narzul/intelligent-patient-record/README.md

intelligent-patient-record
==========================

intelligent patient record
