narzul/intelligent-patient-record/Report/Appendix.tex

\clearpage

\begin{appendices}

\begin{figure}[h]
\setlength{\belowcaptionskip}{-5mm}
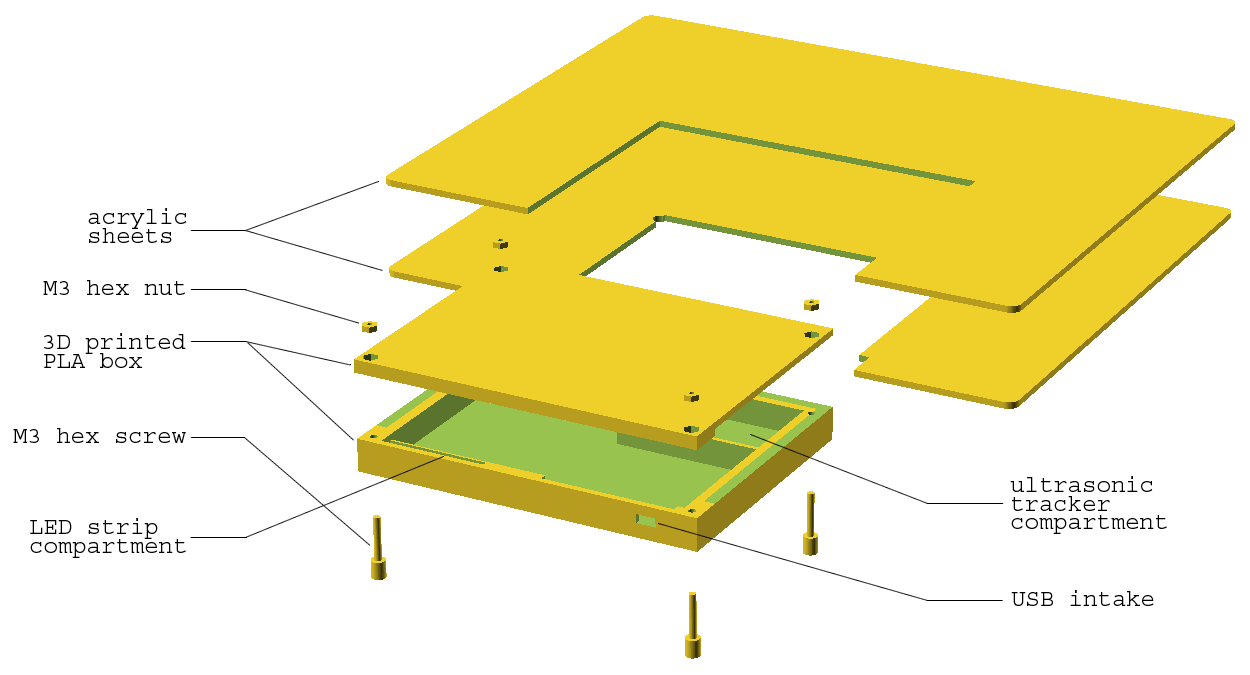
[picture p1: Report/figures/explode.png]
  \makebox[\textwidth][c]{} %
  \caption{\small {\it {Exploded view of the prototype.}}} 
  \label{fig:explode}
\end{figure}

\begin{figure}[h]
\setlength{\belowcaptionskip}{-5mm}
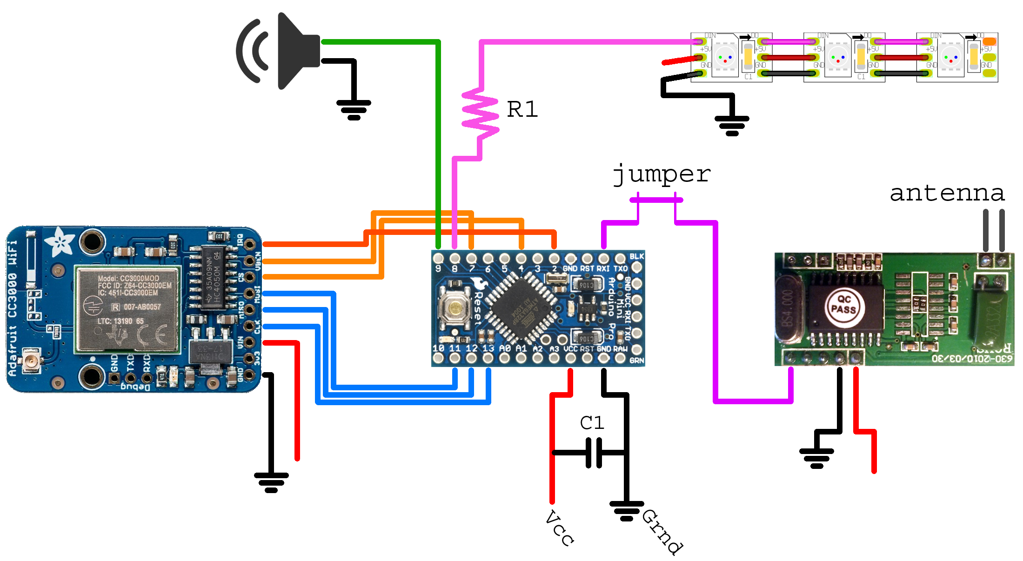
[picture p2: Report/figures/schematic.png]
  \makebox[\textwidth][c]{} %
  \caption{\small {\it {Schematic of the electronics inside.}}} 
  \label{fig:explode}
\end{figure}

\begin{figure}[h]
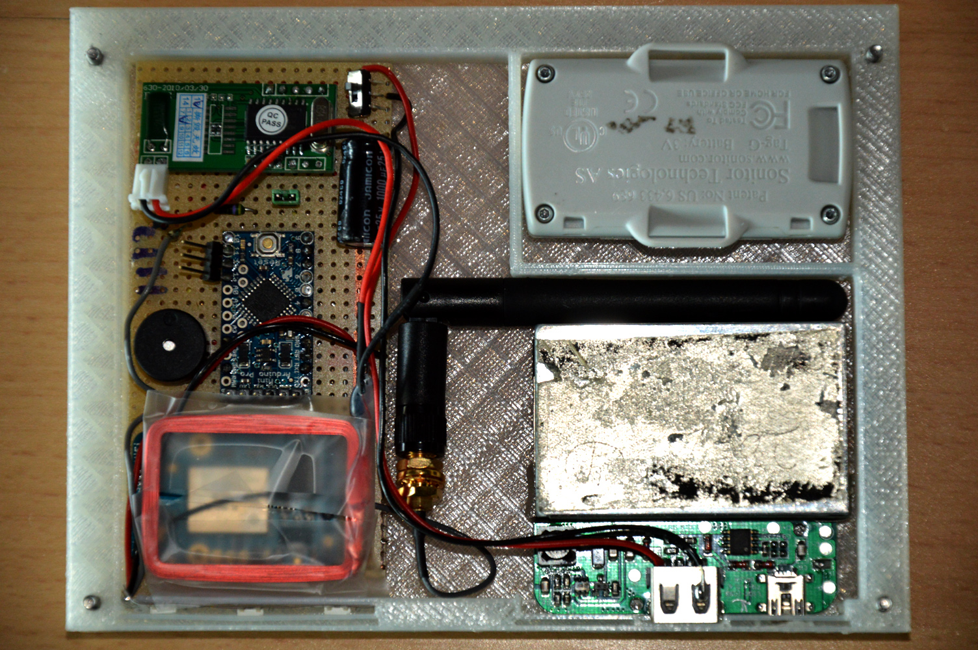
[picture p3: Report/figures/internals.jpg]
  \makebox[\textwidth][c]{}
  \caption{\small {\it {Inside the electronics compartment.}}} 
  \label{fig:internals}
\end{figure}

\begin{figure}[h]
  \begin{minipage}[b]{.5\textwidth}
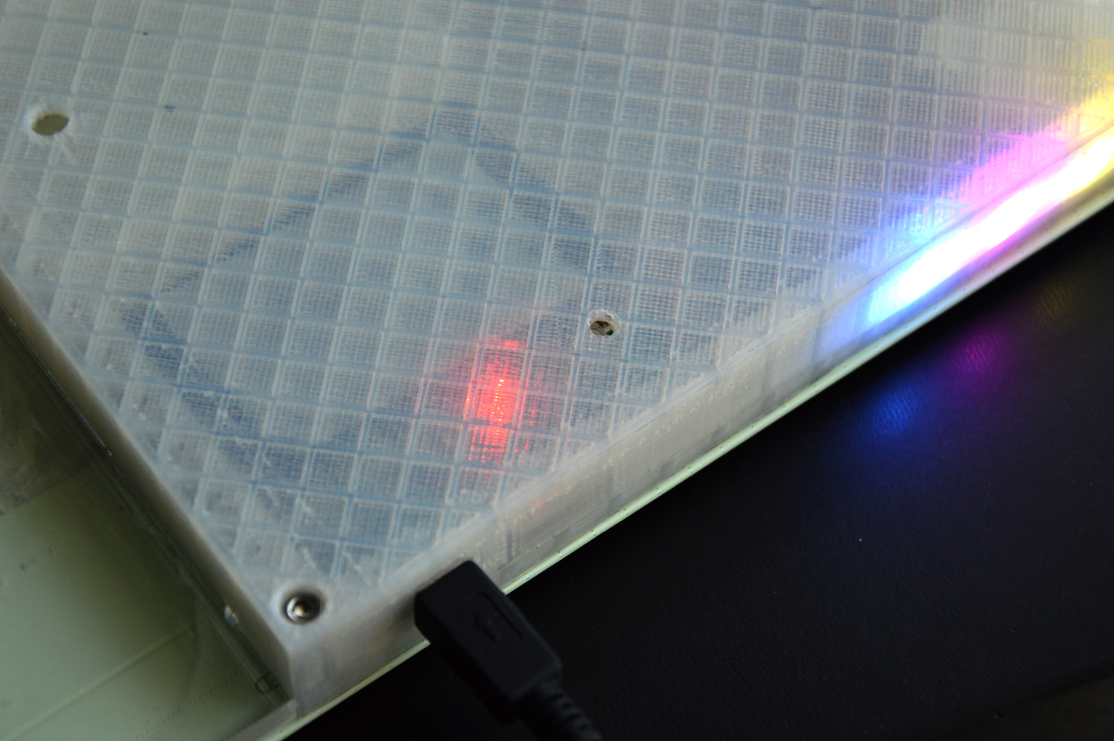
[picture p4: Report/figures/journal-charging.jpg]
    
  \end{minipage}
  \begin{minipage}[b]{.5\textwidth}
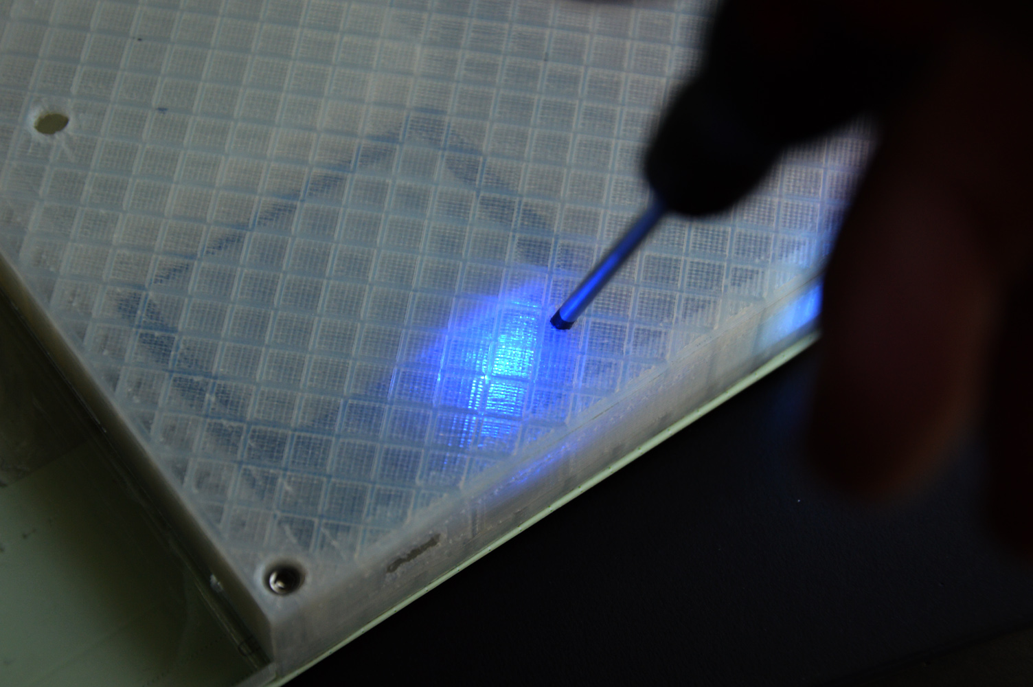
[picture p5: Report/figures/journal-battery.jpg]
    
  \end{minipage}
  \caption{\small {\it {Left: a red LED indicates charging state. Right: a button can be pressed to display battery status.}}}
  \label{fig:journal-2}
\end{figure}

\end{appendices}
