narzul/intelligent-patient-record/Report/main.tex

\documentclass[a4paper,12pt]{article}
\usepackage[utf8]{inputenc}
\usepackage[english]{babel}
\usepackage{url}
\usepackage{graphicx}
\usepackage{array}
\usepackage{geometry}
\usepackage{tabularx}
\usepackage{pgfplots}
\usepackage{amsmath}
\usepackage{amsfonts}
\usepackage{amssymb}
\usepackage{placeins}
\usepackage[toc,page]{appendix}

\setlength\parindent{0pt}

\title{Intelligent Patient Record}

\author{ITU \\
\vspace{5mm}
Mathias Schmidt, Thomas Snaidero \\
Supervisors: \\
Steven Houben, Mads Frost}

\date{6th of August 2014}

\begin{document}

\maketitle
\pagebreak
\tableofcontents
\pagebreak

\input{Introduction.tex}

\input{Theory.tex}

\input{Design-requirements.tex}

%\input{Materials.tex}

\input{Methods.tex}

\input{Design-specifications.tex}

%\input{Evaluation.tex}

\input{Discussion.tex}

\input{Conclusions.tex}

\input{Appendix.tex}

% \input{test.tex}

% \input{Electronic.tex}

% \input{Design.tex}

% \input{Problems.tex}

\clearpage

\bibliographystyle{plain}
\bibliography{References}

\end{document}
