narzul/intelligent-patient-record/Report/Prototyping-analysis.tex

\section{Prototyping analysis}

Discussion of experience in building prototypes during the design process:
- Illustration of all the prototyping activities
- Discussion of specific areas where the experience of building prototypes affected the design requirements and specifications
