narzul/intelligent-patient-record/design files/v2/box/side.pdf

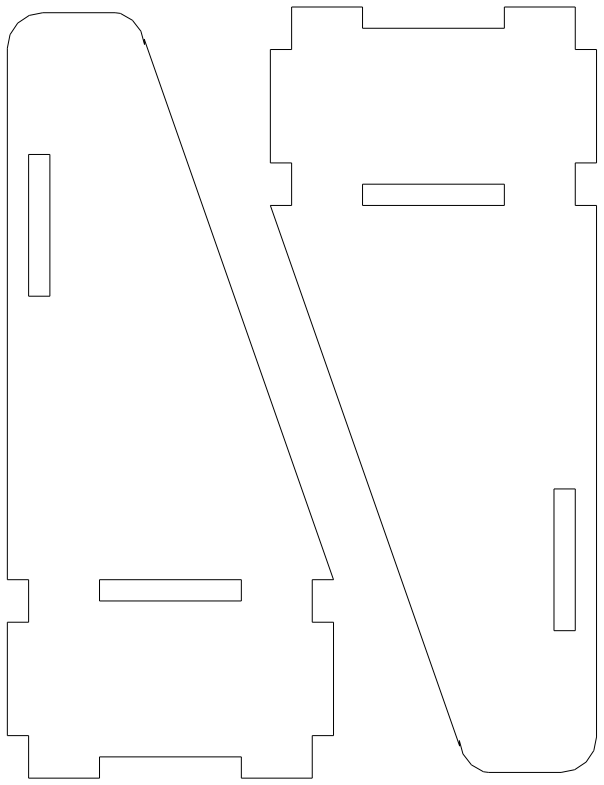
[picture p17: figure]
