narzul/intelligent-patient-record/design files/v6/page/page2.pdf

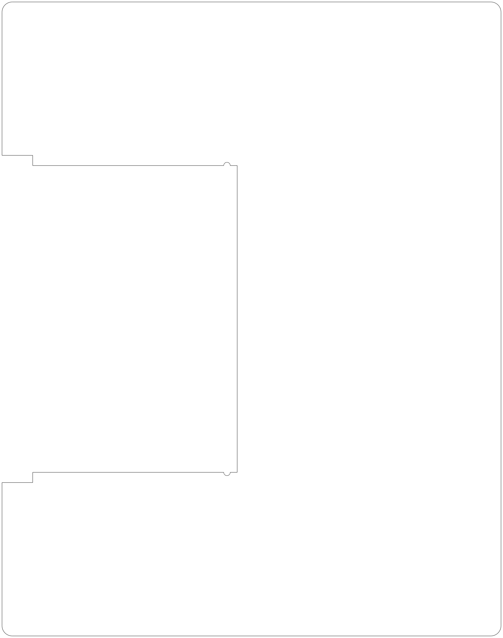
[picture p18: figure]
