narzul/intelligent-patient-record/images/designprocess1.jpg

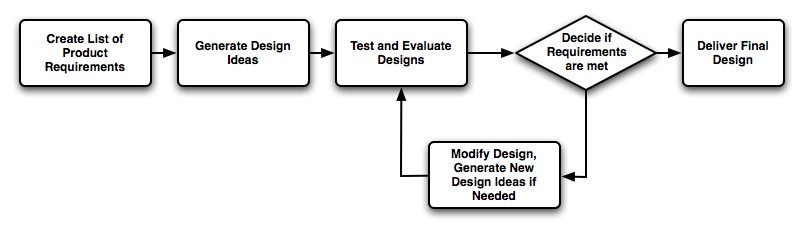
images/designprocess1.jpg
