narzul/intelligent-patient-record/Report/figures/design-process-2.png

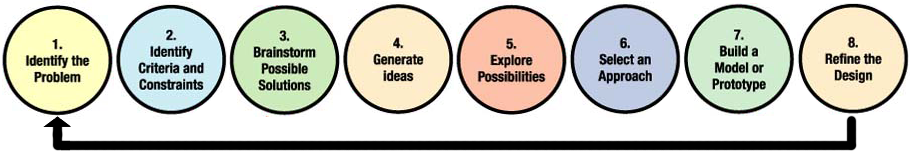
Report/figures/design-process-2.png
