narzul/intelligent-patient-record/Report/figures/design-process-3.png

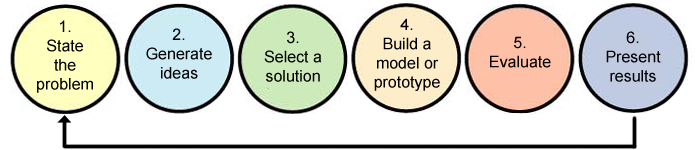
Report/figures/design-process-3.png
