narzul/intelligent-patient-record/Report/figures/design-process.jpg

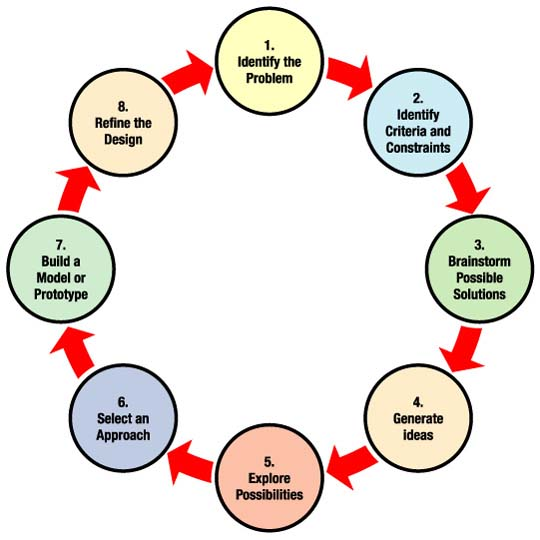
Report/figures/design-process.jpg
