narzul/intelligent-patient-record/Report/figures/iterations/v5-photo.jpg

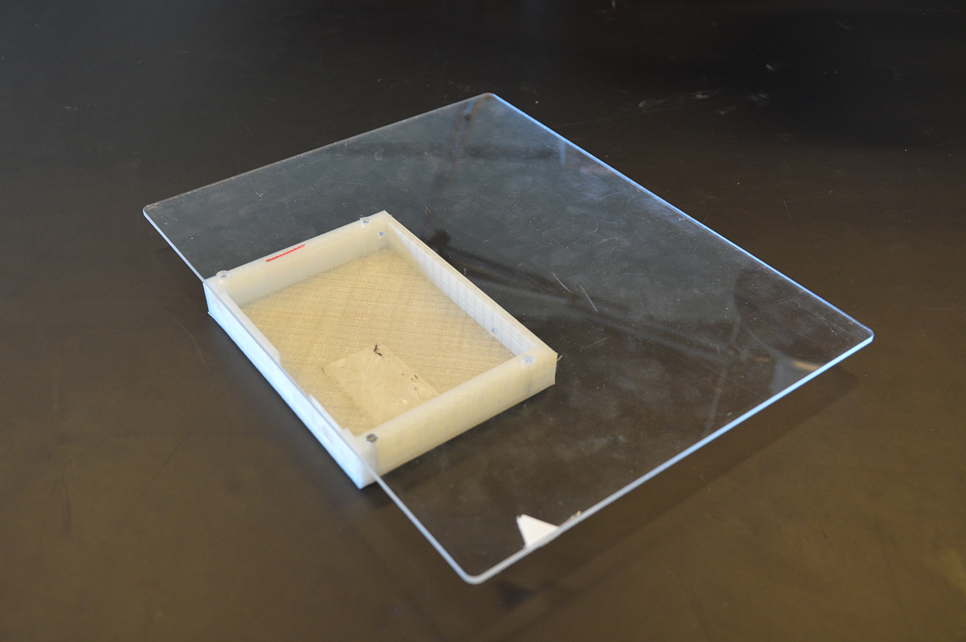
Report/figures/iterations/v5-photo.jpg
