narzul/intelligent-patient-record/Report/figures/iterations/v5.png

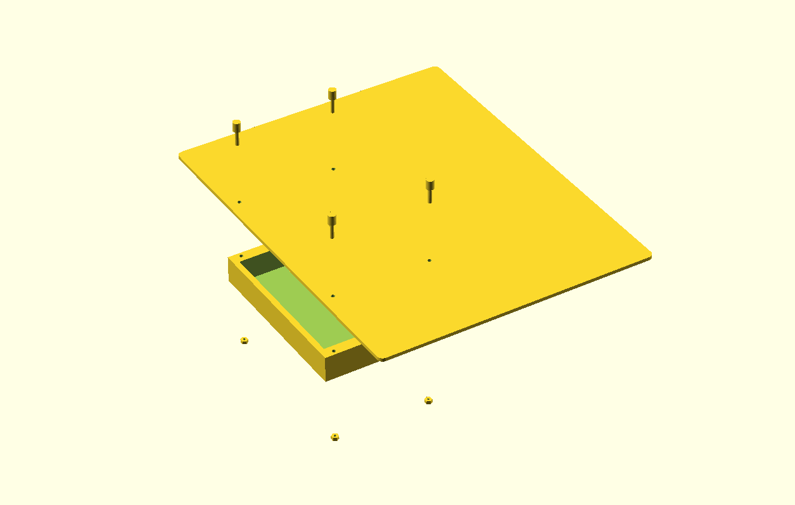
Report/figures/iterations/v5.png
