narzul/intelligent-patient-record/Report/figures/maxbot.jpg

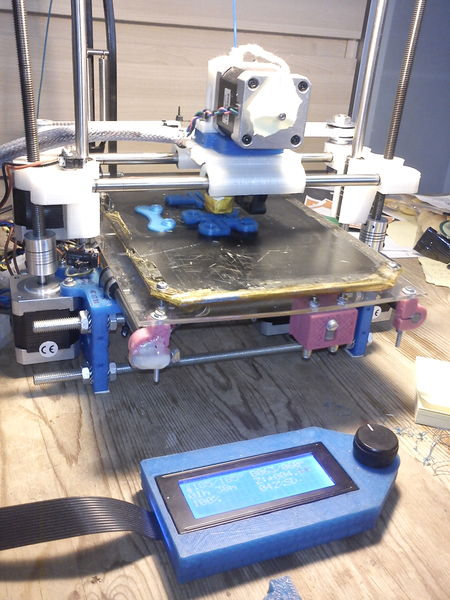
Report/figures/maxbot.jpg
