narzul/intelligent-patient-record/Report/images/version3.png

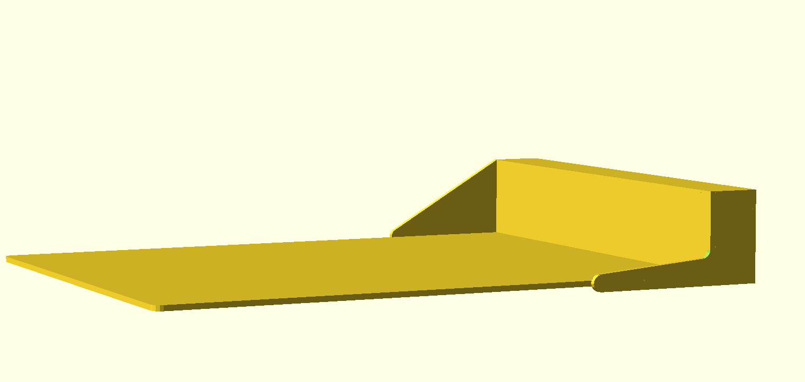
Report/images/version3.png
