narzul/intelligent-patient-record/Report/images/wii-cardboard-1.jpg

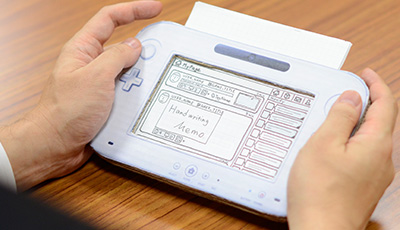
Report/images/wii-cardboard-1.jpg
