narzul/intelligent-patient-record/design files/v7/page/page2.dxf

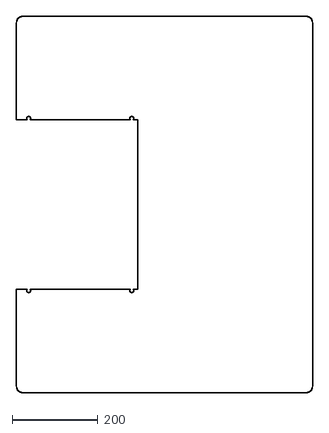
[picture p33: CAD file, 2014-05-07]
design files/v7/page/page2.dxf
691.7 x 878.7
