narzul/intelligent-patient-record/design files/v7/page/page2oneplate.dxf

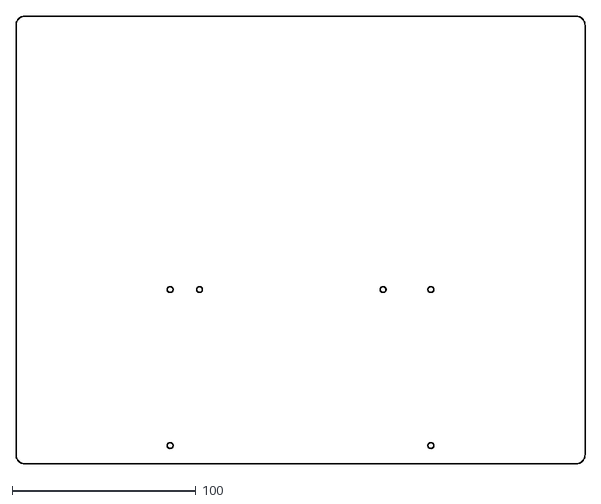
[picture p34: CAD file, 2014-05-07]
design files/v7/page/page2oneplate.dxf
310.0 x 244.0
