narzul/intelligent-patient-record/design files/v7/page/lence.dxf

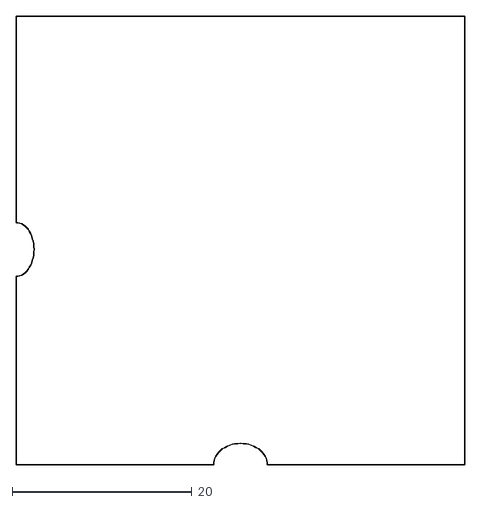
[picture p35: CAD file, 2014-05-07]
design files/v7/page/lence.dxf
50.0 x 50.0
