narzul/intelligent-patient-record/design files/v7/page/page.dxf

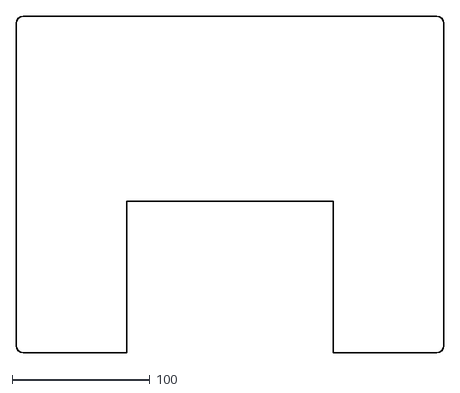
[picture p36: CAD file, 2014-05-07]
design files/v7/page/page.dxf
310.0 x 244.0
