narzul/intelligent-patient-record/design files/v1/box/led/led.dxf

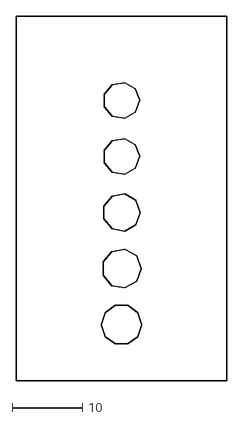
[picture p37: CAD file, 2014-05-07, an earlier design]
design files/v1/box/led/led.dxf
30.0 x 52.0
