narzul/intelligent-patient-record/design files/v1/box/sides.stl

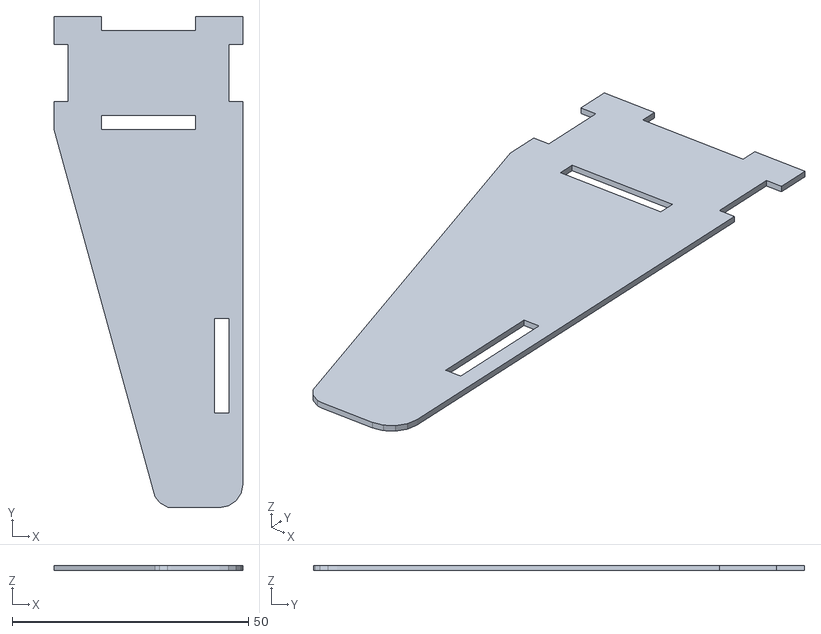
[picture p38: CAD file, 2014-05-15, an earlier design]
design files/v1/box/sides.stl
40.0 x 104.0 x 1.00
