narzul/intelligent-patient-record/design files/v1/middel.stl

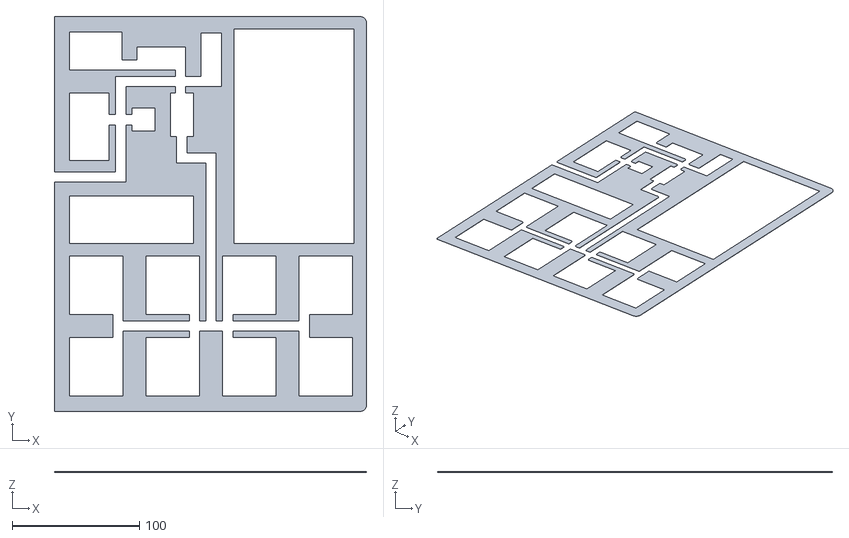
[picture p39: CAD file, 2014-05-15, an earlier design]
design files/v1/middel.stl
245.0 x 310.0 x 1.00
