narzul/intelligent-patient-record/design files/v2/box/poludronside.stl

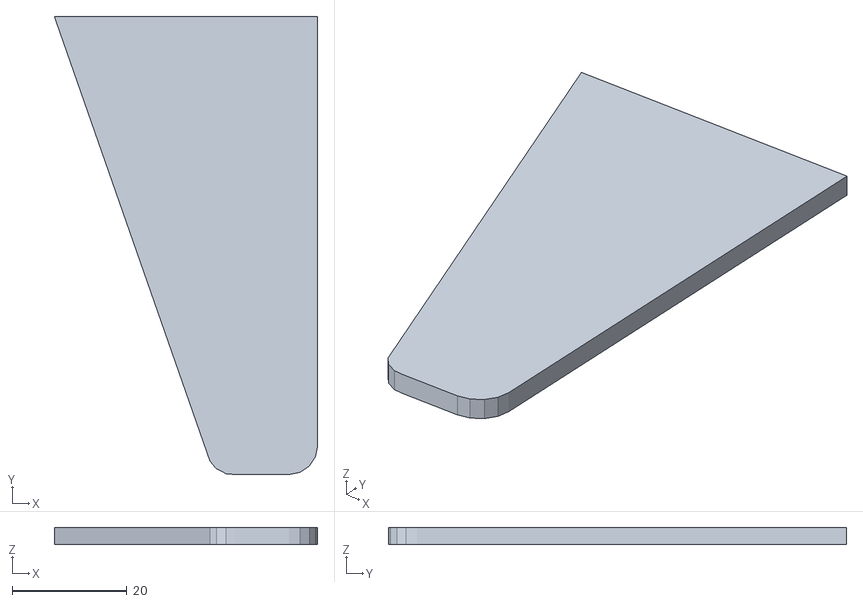
[picture p40: CAD file, 2014-05-07, an earlier design]
design files/v2/box/poludronside.stl
46.0 x 80.0 x 3.00
