narzul/intelligent-patient-record/design files/v3/box/leftside.dxf

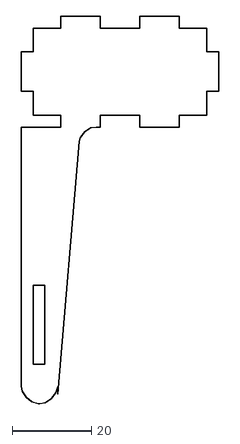
[picture p41: CAD file, 2014-05-07, an earlier design]
design files/v3/box/leftside.dxf
50.0 x 98.0
