narzul/intelligent-patient-record/design files/v3/page/page.dxf

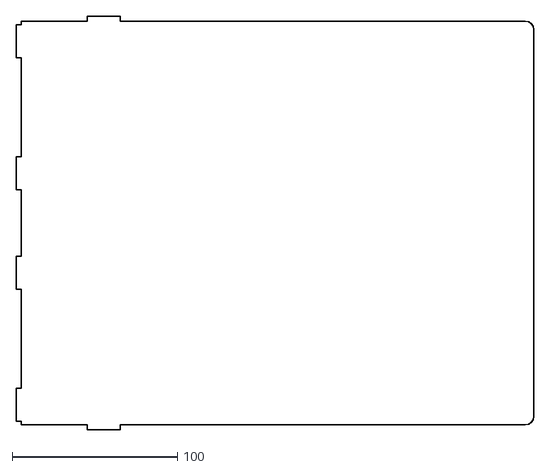
[picture p42: CAD file, 2014-05-07, an earlier design]
design files/v3/page/page.dxf
313.0 x 250.0
