narzul/intelligent-patient-record/design files/v4/box/CutoutTop.stl

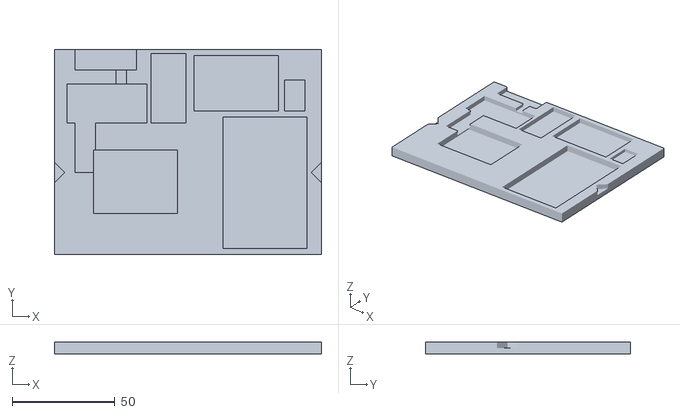
[picture p43: CAD file, 2014-05-07, an earlier design]
design files/v4/box/CutoutTop.stl
130.0 x 100.0 x 6.00
