narzul/intelligent-patient-record/design files/v4/page/page2.dxf

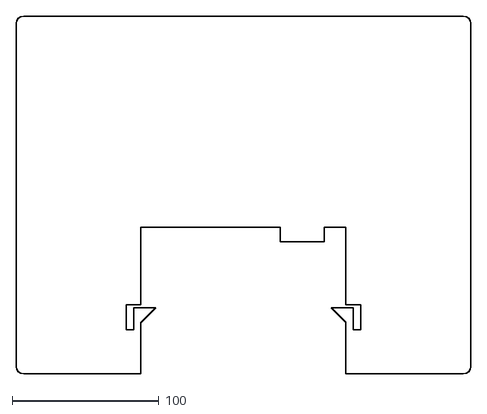
[picture p44: CAD file, 2014-05-07, an earlier design]
design files/v4/page/page2.dxf
310.0 x 244.0
