narzul/intelligent-patient-record/design files/v6/box/Cutout2.stl

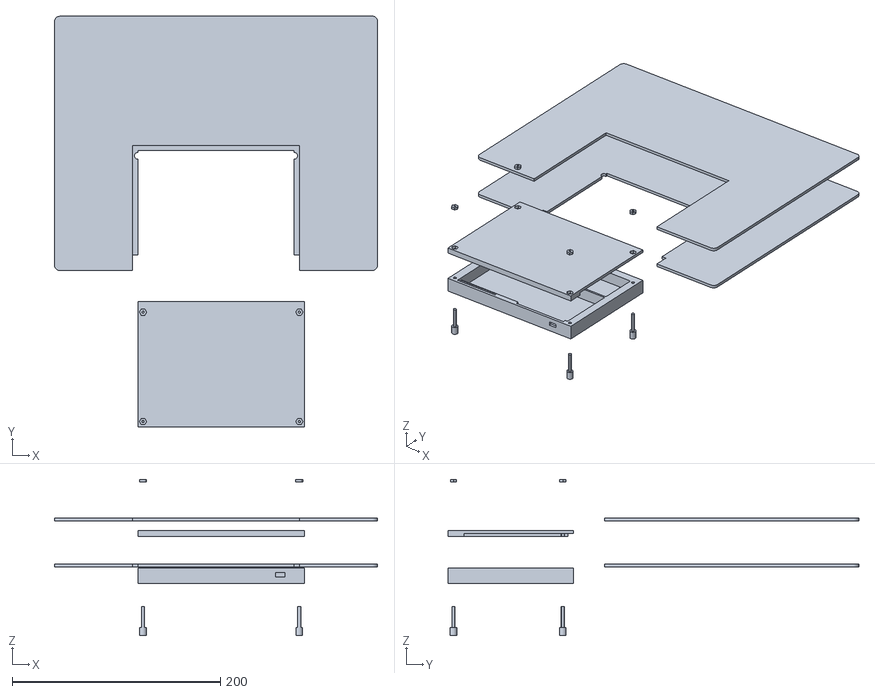
[picture p45: CAD file, 2014-05-13, an earlier design]
design files/v6/box/Cutout2.stl
310.0 x 394.0 x 150.0
