narzul/intelligent-patient-record/design files/v6/page/page.dxf

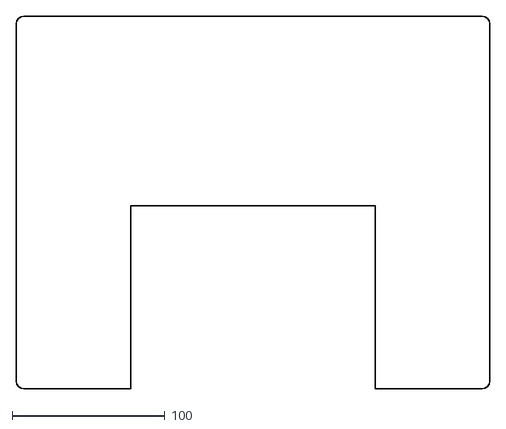
[picture p46: CAD file, 2014-05-07, an earlier design]
design files/v6/page/page.dxf
310.0 x 244.0
