narzul/intelligent-patient-record/design files/v1/box/outsidewall.stl

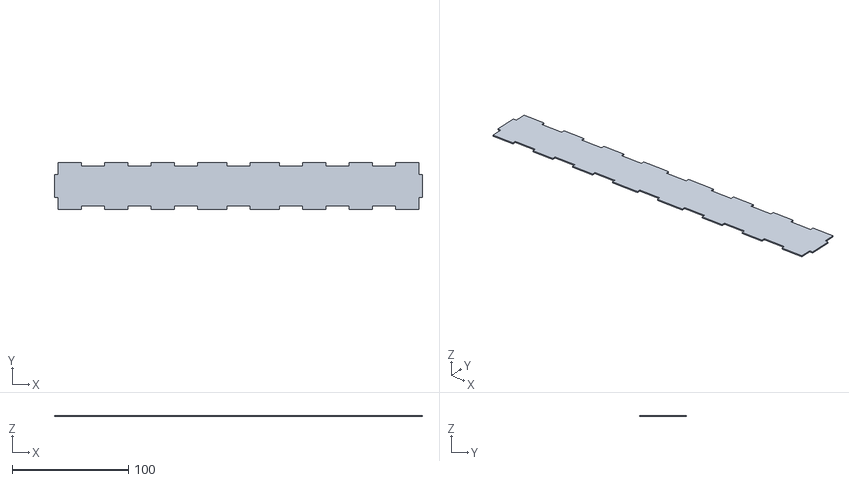
[picture p47: CAD file, 2014-05-15, an earlier design]
design files/v1/box/outsidewall.stl
316.0 x 40.0 x 1.00
