narzul/intelligent-patient-record/design files/v1/topbot.stl

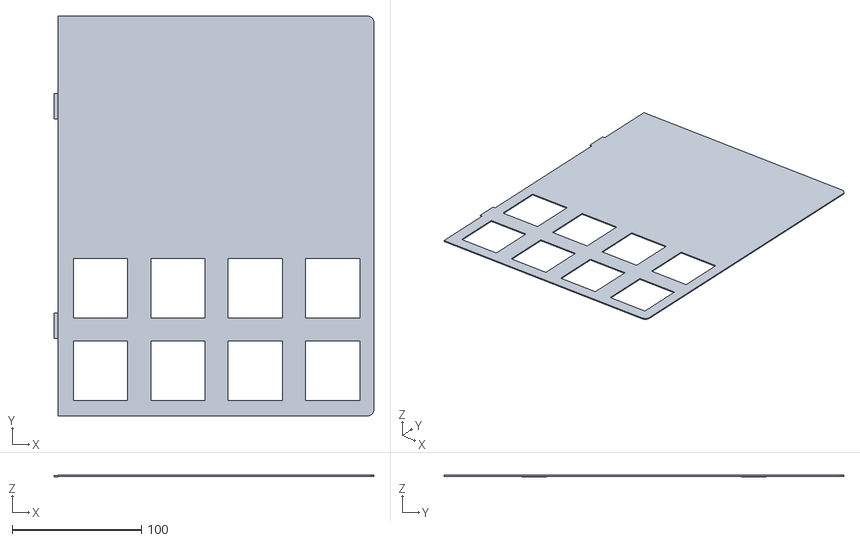
[picture p48: CAD file, 2014-05-15, an earlier design]
design files/v1/topbot.stl
248.0 x 310.0 x 1.50
