narzul/intelligent-patient-record/design files/v2/box/leftside.dxf

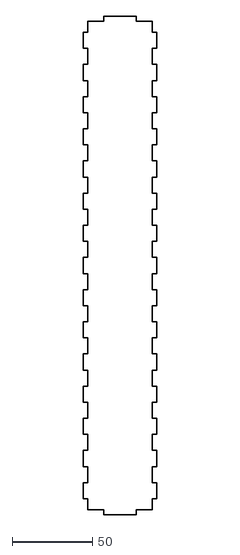
[picture p49: CAD file, 2014-05-07, an earlier design]
design files/v2/box/leftside.dxf
46.0 x 310.0
