narzul/intelligent-patient-record/design files/v7/page/triangle.scad

module triangle()
{
	polyhedron(
  points=[ [0,0,0],[10,0,0],[0,10,0],
				[0,0,3],[10,0,3],[0,10,3]  ],
  triangles=[ [0,1,2],[5,4,3],[5,2,1],[1,4,5],[1,3,4],[2,3,0],[0,3,1],[5,3,2] ]
  );
}
