narzul/intelligent-patient-record/(list of files, cad)

Other CAD files:
design files/v7/box/component2.scad
design files/v7/nutsnbolts-master/examples.scad
design files/v1/Combine.scad
design files/v1/batrast.dxf
design files/v1/batrast.scad
design files/v1/bot.dxf
design files/v1/bot.scad
design files/v1/box/bot.dxf
design files/v1/box/bot.scad
design files/v1/box/bot.stl
design files/v1/box/innersidewall.dxf
design files/v1/box/innersidewall.scad
design files/v1/box/innersidewall.stl
design files/v1/box/led/led.scad
design files/v1/box/outsidewall.dxf
design files/v1/box/outsidewall.scad
design files/v1/box/poludron.scad
design files/v1/box/poludron.stl
design files/v1/box/sides.dxf
design files/v1/box/sides.scad
design files/v1/box/top.dxf
design files/v1/box/top.scad
design files/v1/box/top.stl
design files/v1/cornor.scad
design files/v1/first.dxf
design files/v1/first.scad
design files/v1/first.stl
design files/v1/middel.dxf
design files/v1/middel.scad
design files/v1/project.scad
design files/v1/tempcutout.dxf
design files/v1/tempcutout.scad
design files/v1/th.dxf
design files/v1/th.scad
design files/v1/th.stl
design files/v1/third.scad
design files/v1/top.dxf
design files/v1/top.scad
design files/v1/topbot.dxf
design files/v1/topbot.scad
design files/v2/box/bot.scad
design files/v2/box/combine.scad
design files/v2/box/inside.dxf
design files/v2/box/inside.scad
design files/v2/box/leftside.scad
design files/v2/box/poludronside.scad
design files/v2/box/rightside.scad
design files/v2/box/side.dxf
design files/v2/box/side.scad
design files/v2/box/top.dxf
design files/v2/box/top.scad
design files/v2/box/top2.dxf
design files/v2/box/top2.scad
design files/v3/box/back.dxf
design files/v3/box/back.scad
design files/v3/box/bot.dxf
design files/v3/box/bot.scad
design files/v3/box/front.dxf
design files/v3/box/front.scad
design files/v3/box/leftside.scad
design files/v3/box/rightside.dxf
design files/v3/box/rightside.scad
design files/v3/box/top.dxf
design files/v3/box/top.scad
design files/v3/compine.scad
design files/v3/page/page.scad
design files/v4/box/Cutout.scad
design files/v4/box/Cutout.stl
design files/v4/box/Cutout1.stl
design files/v4/box/component.scad
design files/v4/page/page.dxf
design files/v4/page/page.scad
design files/v4/page/page2.scad
design files/v5/MCAD-master/2Dshapes.scad
design files/v5/MCAD-master/3d_triangle.scad
design files/v5/MCAD-master/bearing.scad
design files/v5/MCAD-master/bitmap/alphabet_block.scad
design files/v5/MCAD-master/bitmap/bitmap.scad
design files/v5/MCAD-master/bitmap/height_map.scad
design files/v5/MCAD-master/bitmap/letter_necklace.scad
design files/v5/MCAD-master/bitmap/name_tag.scad
design files/v5/MCAD-master/boxes.scad
design files/v5/MCAD-master/constants.scad
design files/v5/MCAD-master/curves.scad
design files/v5/MCAD-master/fonts.scad
design files/v5/MCAD-master/gears.scad
design files/v5/MCAD-master/gridbeam.scad
design files/v5/MCAD-master/hardware.scad
design files/v5/MCAD-master/involute_gears.scad
design files/v5/MCAD-master/layouts.scad
design files/v5/MCAD-master/lego_compatibility.scad
design files/v5/MCAD-master/libtriangles.scad
design files/v5/MCAD-master/materials.scad
design files/v5/MCAD-master/math.scad
design files/v5/MCAD-master/metric_fastners.scad
design files/v5/MCAD-master/motors.scad
design files/v5/MCAD-master/multiply.scad
design files/v5/MCAD-master/nuts_and_bolts.scad
design files/v5/MCAD-master/polyholes.scad
design files/v5/MCAD-master/regular_shapes.scad
design files/v5/MCAD-master/screw.scad
design files/v5/MCAD-master/servos.scad
design files/v5/MCAD-master/shapes.scad
design files/v5/MCAD-master/stepper.scad
design files/v5/MCAD-master/teardrop.scad
design files/v5/MCAD-master/transformations.scad
design files/v5/MCAD-master/triangles.scad
design files/v5/MCAD-master/trochoids.scad
design files/v5/MCAD-master/units.scad
design files/v5/MCAD-master/unregular_shapes.scad
design files/v5/MCAD-master/utilities.scad
design files/v5/box/Cutout.scad
design files/v5/box/component.scad
design files/v5/nutsnbolts-master/cyl_head_bolt-drawAllScript.scad
design files/v5/nutsnbolts-master/cyl_head_bolt.scad
design files/v5/nutsnbolts-master/data-access.scad
design files/v5/nutsnbolts-master/data-metric_cyl_head_bolts.scad
design files/v5/nutsnbolts-master/examples.scad
design files/v5/nutsnbolts-master/materials.scad
design files/v5/page/page.scad
design files/v6/MCAD-master/2Dshapes.scad
design files/v6/MCAD-master/3d_triangle.scad
design files/v6/MCAD-master/bearing.scad
design files/v6/MCAD-master/bitmap/alphabet_block.scad
design files/v6/MCAD-master/bitmap/bitmap.scad
design files/v6/MCAD-master/bitmap/height_map.scad
design files/v6/MCAD-master/bitmap/letter_necklace.scad
design files/v6/MCAD-master/bitmap/name_tag.scad
design files/v6/MCAD-master/boxes.scad
design files/v6/MCAD-master/constants.scad
design files/v6/MCAD-master/curves.scad
design files/v6/MCAD-master/fonts.scad
design files/v6/MCAD-master/gears.scad
design files/v6/MCAD-master/gridbeam.scad
design files/v6/MCAD-master/hardware.scad
design files/v6/MCAD-master/involute_gears.scad
design files/v6/MCAD-master/layouts.scad
design files/v6/MCAD-master/lego_compatibility.scad
design files/v6/MCAD-master/libtriangles.scad
design files/v6/MCAD-master/materials.scad
design files/v6/MCAD-master/math.scad
design files/v6/MCAD-master/metric_fastners.scad
design files/v6/MCAD-master/motors.scad
design files/v6/MCAD-master/multiply.scad
design files/v6/MCAD-master/nuts_and_bolts.scad
design files/v6/MCAD-master/polyholes.scad
design files/v6/MCAD-master/regular_shapes.scad
design files/v6/MCAD-master/screw.scad
design files/v6/MCAD-master/servos.scad
design files/v6/MCAD-master/shapes.scad
design files/v6/MCAD-master/stepper.scad
design files/v6/MCAD-master/teardrop.scad
design files/v6/MCAD-master/transformations.scad
design files/v6/MCAD-master/triangles.scad
design files/v6/MCAD-master/trochoids.scad
design files/v6/MCAD-master/units.scad
design files/v6/MCAD-master/unregular_shapes.scad
design files/v6/MCAD-master/utilities.scad
design files/v6/box/Cutout.scad
design files/v6/box/Cutout2.scad
design files/v6/box/CutoutBot.stl
design files/v6/box/CutoutTop.stl
design files/v6/box/component.scad
design files/v6/nutsnbolts-master/cyl_head_bolt-drawAllScript.scad
design files/v6/nutsnbolts-master/cyl_head_bolt.scad
design files/v6/nutsnbolts-master/data-access.scad
design files/v6/nutsnbolts-master/data-metric_cyl_head_bolts.scad
design files/v6/nutsnbolts-master/examples.scad
design files/v6/nutsnbolts-master/materials.scad
design files/v6/page/page.scad
design files/v6/page/page2.dxf
design files/v6/page/page2.scad
design files/v7/MCAD-master/2Dshapes.scad
design files/v7/MCAD-master/3d_triangle.scad
design files/v7/MCAD-master/bearing.scad
design files/v7/MCAD-master/bitmap/alphabet_block.scad
design files/v7/MCAD-master/bitmap/bitmap.scad
design files/v7/MCAD-master/bitmap/height_map.scad
design files/v7/MCAD-master/bitmap/letter_necklace.scad
design files/v7/MCAD-master/bitmap/name_tag.scad
design files/v7/MCAD-master/boxes.scad
design files/v7/MCAD-master/constants.scad
design files/v7/MCAD-master/curves.scad
design files/v7/MCAD-master/fonts.scad
design files/v7/MCAD-master/gears.scad
design files/v7/MCAD-master/gridbeam.scad
design files/v7/MCAD-master/hardware.scad
design files/v7/MCAD-master/involute_gears.scad
design files/v7/MCAD-master/layouts.scad
design files/v7/MCAD-master/lego_compatibility.scad
design files/v7/MCAD-master/libtriangles.scad
design files/v7/MCAD-master/materials.scad
design files/v7/MCAD-master/math.scad
design files/v7/MCAD-master/metric_fastners.scad
design files/v7/MCAD-master/motors.scad
design files/v7/MCAD-master/multiply.scad
design files/v7/MCAD-master/nuts_and_bolts.scad
design files/v7/MCAD-master/polyholes.scad
design files/v7/MCAD-master/regular_shapes.scad
design files/v7/MCAD-master/screw.scad
design files/v7/MCAD-master/servos.scad
design files/v7/MCAD-master/shapes.scad
design files/v7/MCAD-master/stepper.scad
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
