narzul/intelligent-patient-record/images/engineering-method-steps_v7.png

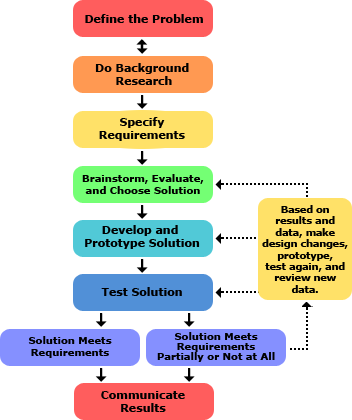
images/engineering-method-steps_v7.png
