narzul/intelligent-patient-record/Report/test.tex

\section{TESTING - ignore}

\begin{figure}[h]
\begin{center}

\caption{\small {\it {This is a description}}} \label{fig:testfig0}
\end{center}
\end{figure}

\begin{figure}[h]
\begin{minipage}[b]{7.5cm}
\centering

\caption{\small {\it {This is a description}}} \label{fig:testfig1}
\end{minipage}
% \hspace{0.5cm}
\begin{minipage}[b]{7.5cm}
\centering

\caption{\small {\it {This is a description}}} \label{fig:testfig2}
\end{minipage}
\end{figure}

\begin{itemize} \itemsep0em
  \item The individual entries are indicated with a black dot, a so-called bullet \cite{chua2010}.
  \item The text in the entries may be of any length on figure \ref{fig:testfig1}.
\end{itemize}
