narzul/intelligent-patient-record/Report/figures/journal-crack.jpg

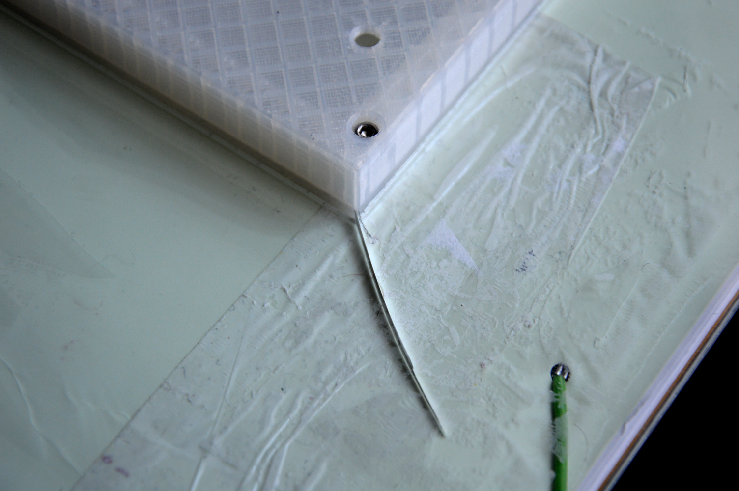
Report/figures/journal-crack.jpg
