narzul/intelligent-patient-record/design files/v7/page/page2.pdf

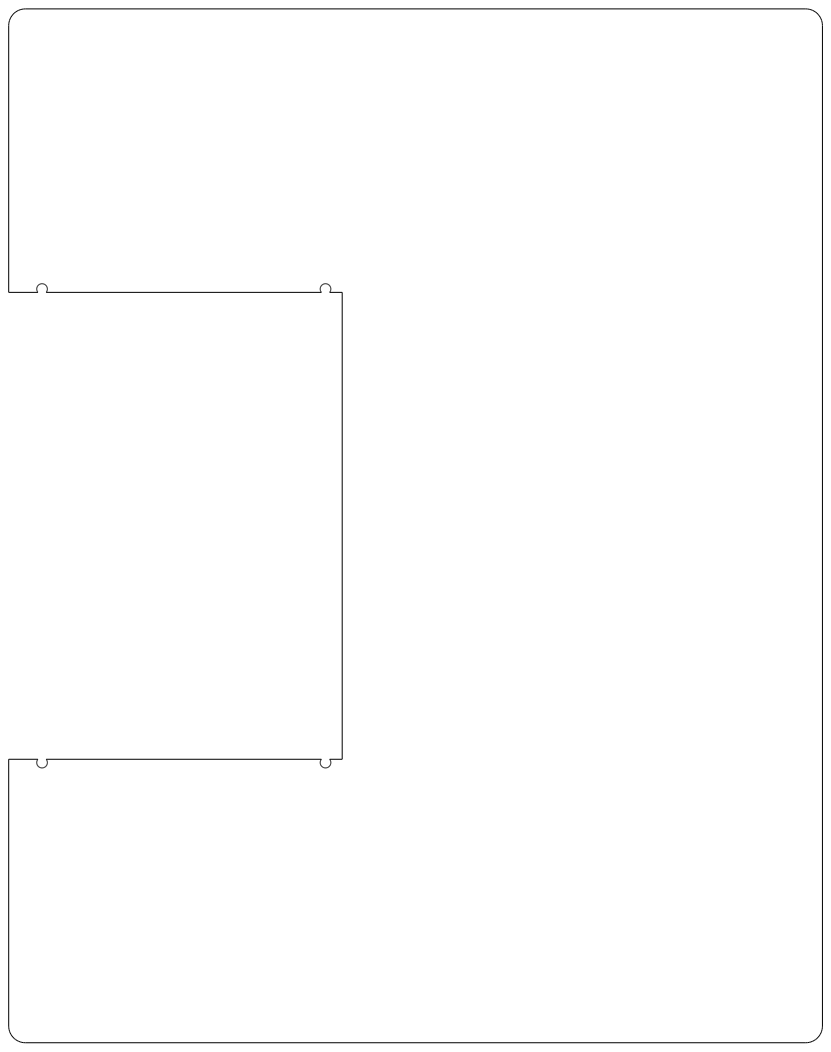
[picture p52: page 1]
