narzul/intelligent-patient-record/design files/v7/page/page2oneplate.pdf

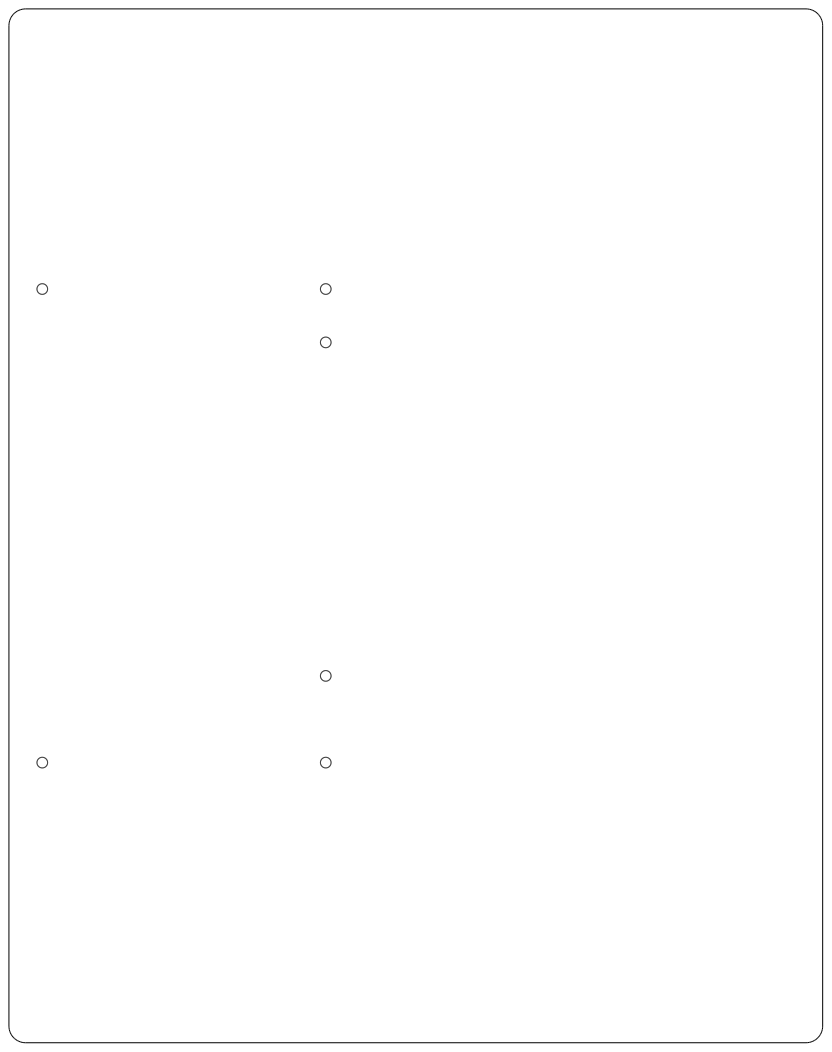
[picture p53: page 1]
