narzul/intelligent-patient-record/(commit log)

2014-05-07 design files, plast pic from test
    [2Dshapes.scad, 3d_triangle.scad, Cutout.scad, Cutout.stl, Cutout1.stl, Cutout2.scad, CutoutBot.stl, CutoutTop.stl]
2014-05-13 update design file v6. new file Cutout2.scad, for picture
    [Combine.scad, Cutout.scad, Cutout2.scad, first.scad, middel.scad, page.scad, page2.scad, third.scad]
2014-05-13 stl file update
    [Cutout2.stl]
2014-05-14 materials and methods
